righttoroam/stantonbury/09_Reference/Display data/70-800x480-tft-lcd-display-mit-touchscreen-ssd1963-mcu-arduino-kompatibel_3.webp

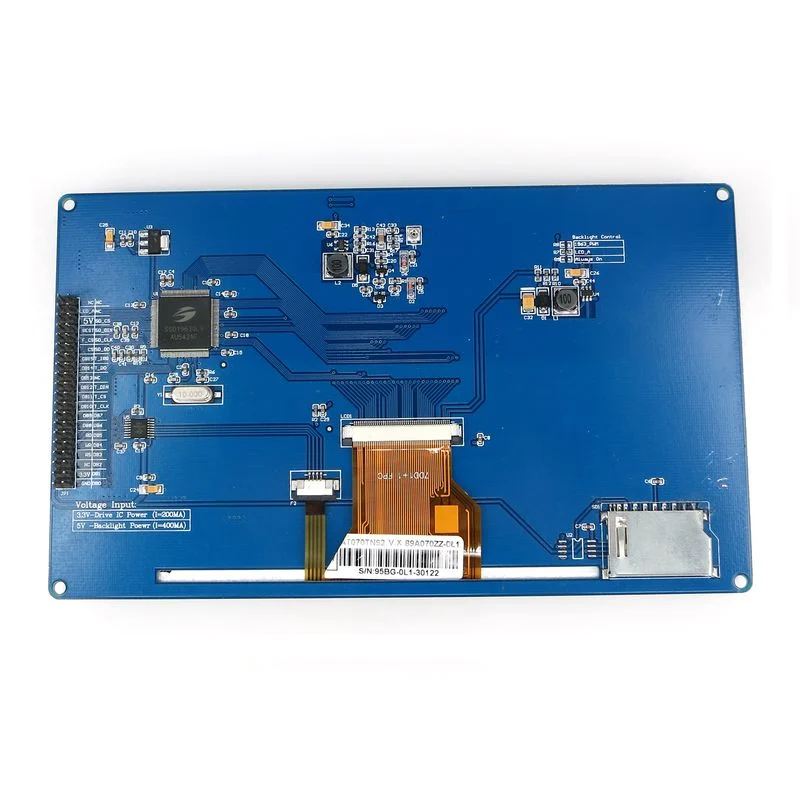
09_Reference/Display data/70-800x480-tft-lcd-display-mit-touchscreen-ssd1963-mcu-arduino-kompatibel_3.webp
