righttoroam/stantonbury/09_Reference/RF-Kit/IMG_2352.jpg

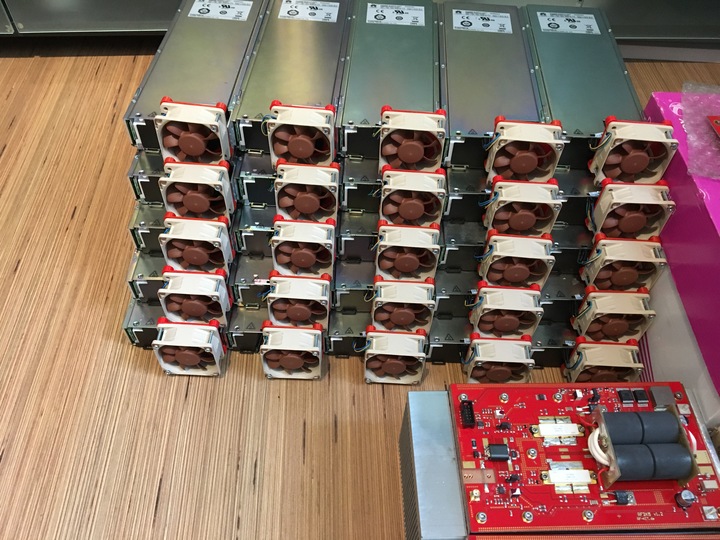
09_Reference/RF-Kit/IMG_2352.jpg
