righttoroam/stantonbury/01_Requirements/PA600 target spec.odt

Target Specification for PA600 Power Amp

Parameter | Target | Compliance
Band coverage | 160 - 6m | Yes
Power output | P1dB >600W on all bands | Yes
IMD3 | <-30dB(PEP) | Yes
Spurious | <-46dBc, 160-10m <-70dBc, 6m | Yes
Input VSWR | <1.5 | Yes
Drive power | options for 5W, 10W or 50W PEP input | Yes
Output VSWR | <1.5 | Yes
Gain variation | <3.0dB across 160 - 10m | TBD
Antenna ports | 2 | Yes
Rating | Continuous transmit: - 600W SSB/CW - 300W RTTY/data Intermittent transmit: - 600W key down for 5 minutes key down followed by 5 minutes rest | Yes
Band selection | Manual Automatic based on transmit frequency Icom C-IV interface Icom Analogue band control | Yes Yes Yes Yes
Operator interface | 4.3 inch or larger touch panel | Yes
Metering | Idd, Vdd, output power, VSWR, temperature | Yes
Safety protection | Over-current, over-temperature, high VSWR, excess drive, wrong band selection | Yes
Remote operation | WiFi | TBD
Acoustic noise | <40dB(A) at 1m | TBD
Mass | <10kg | TBD
Dimensions | Stretch target - Unicase 4 (261 x 300 x 135mm) | TBD
AC input | 220-240V, 50Hz, 5A | Yes
Materials cost | <£1500 | Yes
