righttoroam/stantonbury/02_System_design/Mass estimate.ods

Sheet: Mass budget
Item | Estimated mass kg | Comments
Enclosure | 1.85 | Based on measurement of Metcase Unicase 4
Misc hardware | 0.75 | Screws, connectors, cables, bracketry, fans.
PSU | 1.50 | Datasheet for MSP-1000-48
Pallet
Heatsink | 1.80 | Fischer LA 7 weight 2700g including 100x100x10mm spreader and fans. 0.075K/W, 35 deg rise at 1000W out, 65% efficiency
Spreader | 0.90 | Thinner spreader may be possible depending on thermal design
Fans | 0.18
Fixings | 0.10
Ancilliary components | 0.10 | Some reduction possible from higher integration
LPF |  | W6PQL version weighs 610g. Estimate current design weighs about 1kg. 100g reduction possible from smaller board.
Relays | 0.10
Toroids | 0.35
Misc compts | 0.10
PCB | 0.15
Total estimate | 7.88
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
