righttoroam/stantonbury/02_System_design/Thermal design/Heatsink calc.ods

PA Heatsink Calculator
Parameter | Value | Units | Comments | Key
RF output PEP | 600 | Watts |  | Input
Efficiency | 60% |  |  | Intermediate calc
Peak thermal power | 400 | Watts |  | Result
Mean to peak ratio | 50%
 |  |  |  | Constants
Mean dissipation calculation |  |  |  | s.h.c. of copper | 377 | J/(kg.K)
Mean heat to dissipate | 200 | Watts |  | s.h.c of alu | 921 | J/(kg.K)
Tj max | 175 | C | Max device junction temp | density of cu | 9000 | kg/m^3
Rjc | 0.55 | C/W | Thermal resistance junction to case | density of alu | 2700 | kg/m^3
Rcs | 0.05 | C/W | Thermal resistance case to heatsink
Max sink temp | 55 | C
Inlet temperature | 25 | C
Sink thermal resistance | 0.15 | C/W | NB this is at the max sink temp
Dynamic thermal response
Start temp | 25 | C
Key down period | 300 | secs
Net heat input | 200 | Watts
Thermal energy | 60000 | J
Spreader copper mass (from below) | 0.9 | kg | Density of cu is 9000kg/m^3
Heatsink alu mass | 1.7 | kg | Density of alu is 2700kg/m^3
Heatsink thermal capacity | 1905 | J/K
Temp rise | 31.5 | K
Final temp | 56 | C
Spreader mass estimate
height | 10 | mm
width | 100 | mm
length | 100 | mm
Mass | 0.9 | kg
