righttoroam/stantonbury/03_Detailed_design/Controller/PA600 Micro Pin Assignments V3.ods

 | Pin No | Assignments in code (pin name or alias for pin name) |  | PCB Assignments | Description | Suggested Changes
PA0 | 23 | Uband ADC123_IN0 |  | . | Analogue band input
PA1 | 24 |  |  | NC
PA2 | 25 | USART1 TX |  | WiFiRXD
PA3 | 26 | USART1 RX |  | WiFiTXD
PA4 | 29 | UMESS ADC12_IN4 |  | . | Power supply volts 2.5V = 100V supply
PA5 | 30 | UFWDANT ADC12_IN5 |  | . | Ant Fwd
PA6 | 31 | UREVANT ADC12_IN6 |  | . | Ant Rev
PA7 | 32 | UTEMP ADC12_IN7 |  | . | Temp 1
PA8 | 67 | SW_ONOFF_IN_PA8 |  | NC |  | Delete – Function unknown
PA9 | 68 | USART2 TX |  | CiV TX
PA10 | 69 | USART2 RX |  | CiV RX
PA11 | 70 | SW_RESET_IN_PA11 |  | NC |  | Delete – Function unknown
PA12 | 71 | SW_STANDBY_IN_PA12 |  | NC |  | Delete – Function unknown
PA13 | 72 |  |  | Prog JTMS
PA14 | 76 |  |  | Prog JTCK
PA15 | 77 | ROTS_AUTO_IN_PA15 |  | NC |  | Delete – Was manual LPF input
PB0 | 35 | IMESS ADC12_IN8 |  | . | Supply Current
PB1 | 36 | UFWDIN ADC12_IN9 |  | . | Input Fwd
PB2 | 37 |  |  | Gnd (Boot)
PB3 | 89 |  |  | Prog JTDO
PB4 | 90 | PB4 – LEDRD |  | NJRST (LED Cathode)
PB5 | 91 | PB5 – LEDGN |  | (LED Cathode)
PB6 | 92 | ANT_SEL1_OUT_PB6 |  | . | Antenna select output
PB7 | 93 | BANDREL_1715_OUT_PB7 |  | . | LPF Band Select
PB8 | 95 | ROTS_80M_IN_PB8 |  | TRX Detector pin 3 |  | Delete – Was manual LPF input or multi TX input
PB9 | 96 | BANDREL_1210_OUT_PB9 |  | . | LPF Band Select
PB10 | 47 | USART3 TX |  | UART TX (Bootloader)
PB11 | 48 | USART3 RX |  | UART RX (Bootloader)
PB12 | 51 | BANDREL_6_OUT_PB12 |  | . | LPF Band Select
PB13 | 52 | FATFS_SPI |  | SD_CLK | SD Card
PB14 | 53 | FATFS_SPI |  | SD_DO | SD Card
PB15 | 54 | FATFS_SPI |  | SD_DIN | SD Card
PC0 | 15 | UFWDFLT ADC123_IN10 |  | . | Filter Fwd
PC1 | 16 | UREVFLT ADC123_IN11 | Safety shutdowns | . | Filter Rev
PC2 | 17 | UREVIN ADC123_IN12 |  | . | Input Rev | Delete – No need to measure VSWR on input
PC3 | 18 | UTEMP2 ADC123_IN13 |  | . | Temp 2 | Delete – We only need 1 temperature input
PC4 | 33 | ROTS_6040M_IN_PC4 |  | TRX Detector pin 5 |  | Delete – Was manual LPF input or multi TX input
PC5 | 34 | ROTS_3020M_IN_PC5 |  | TRX Detector pin 7 |  | Delete – Was manual LPF input or multi TX input
PC6 | 63 | ROTS_1715M_IN_PC6 |  | NC |  | Delete – Was manual LPF input
PC7 | 64 | ROTS_1210M_IN_PC7 |  | NC |  | Delete – Was manual LPF input
PC8 | 65 | ROTS_6M_IN_PC8 |  | NC |  | Delete – Was manual LPF input
PC9 | 66 | XPT2046_PORT/XPT2046_CS_PIN |  | T_CS | Touch Screen
PC10 | 78 | XPT2046_PORT/XPT2046_SCK_PIN |  | T_CLK | Touch Screen
PC11 | 79 | XPT2046_PORT/XPT2046_MISO_PIN |  | T_DO | Touch Screen
PC12 | 80 | XPT2046_PORT/XPT2046_MOSI_PIN |  | T_DIN | Touch Screen
PC13 | 7 | ROTS_160M_IN_PC13 |  | TRX Detector pin 1 |  | Was manual LPF input or multi TX input. Repurpose for fan control #2
PC14 | 8 | BANDREL_80_OUT_PC14 |  | . | LPF Band Select
PC15 | 9 | BANDREL_6040_OUT_PC15 |  | . | LPF Band Select
PD0 | 81 | PD0 – hardcoded |  | FMC_D2 | Display data | Note – display interface is very hardcoded and looks pretty messy
PD1 | 82 | PD1 – hardcoded |  | FMC_D3 | Display data
PD2 | 83 | PSOFF_OUT_PD2 |  | .
PD3 | 84 | FATFS_CS_PORT/FATFS_CS_PIN |  | Disp SD_CS | Display
PD4 | 85 | PD4 – hardcoded |  | Disp /RD | Display
PD5 | 86 | PD5 – hardcoded |  | Disp /WR | Display
PD6 | 87 | ICOM_TKEY_IN_PD6 |  | NC |  | Delete – Not used in vserion 7.2 board
PD7 | 88 | PD7 – hardcoded |  | Disp /CS | Display
PD8 | 55 | PD8 – hardcoded |  | FMC_D13 | Display data
PD9 | 56 | PD9 – hardcoded |  | FMC_D14 | Display data
PD10 | 57 | PD10 – hardcoded |  | FMC_D15 | Display data
PD11 | 58 | PD11 – hardcoded |  | Disp RS | Display
PD12 | 59 | PD12 - hardcoded |  | Disp /RES | Display
PD13 | 60 | ANT_SEL2_OUT_PD13 |  |  | Antenna select output | Delete – We only need 2 antenna sockets
PD14 | 61 | PD14 – hardcoded |  | FMC_D0 | Display data
PD15 | 62 | PD15 – hardcoded |  | FMC_D1 | Display data
PE0 | 97 | BANDREL_3020_OUT_PE0 |  | . | LPF Band Select
PE1 | 98 | LCD_BACKLIGHT_OUT_PE1 |  | . | LCD Bavklight control
PE2 | 1 | PTTIN_IN_PE2 |  | . | PTT Input
PE3 | 2 | PSON_OUT_PE3 |  | . | Power On
PE4 | 3 | FAN_OUT_PE4 |  | . | Fan Control | Re-purpose for Fan control #1
PE5 | 4 | BIAS_OUT_PE5 |  | NC |  | Bias On
PE6 | 5 | PTTOUT_OUT_PE6 |  | . |  | Change to TX relay
PE7 | 38 | PE7 - hardcoded |  | FMC_D4 | Display data
PE8 | 39 | PE8 – hardcoded |  | FMC_D5 | Display data
PE9 | 40 | PE9 – hardcoded |  | FMC_D6 | Display data
PE10 | 41 | PE10 – hardcoded |  | FMC_D7 | Display data
PE11 | 42 | PE11 – hardcoded |  | FMC_D8 | Display data
PE12 | 43 | PE12 – hardcoded |  | FMC_D9 | Display data
PE13 | 44 | PE13 – hardcoded |  | FMC_D10 | Display data
PE14 | 45 | PE14 – hardcoded |  | FMC_D11 | Display data
PE15 | 46 | PE15 – hardcoded |  | FMC_D12 | Display data
VBAT | 6
VDD1 | 50
VDD2 | 75
VDD3 | 100
VDD4 | 28
VDD5 | 11
VDD12 | 19
VDDA | 22
VSSA | 20
VSS2 | 74
VSS4 | 27
VSS5 | 10
VREF | 21
VCAP1 | 49
VCAP2 | 73
BOOT0 | 94
OSCin | 12
OSCout | 13
RFV | 99
RST | 14
