righttoroam/stantonbury/09_Reference/M0HZH/circuit-schematic.png

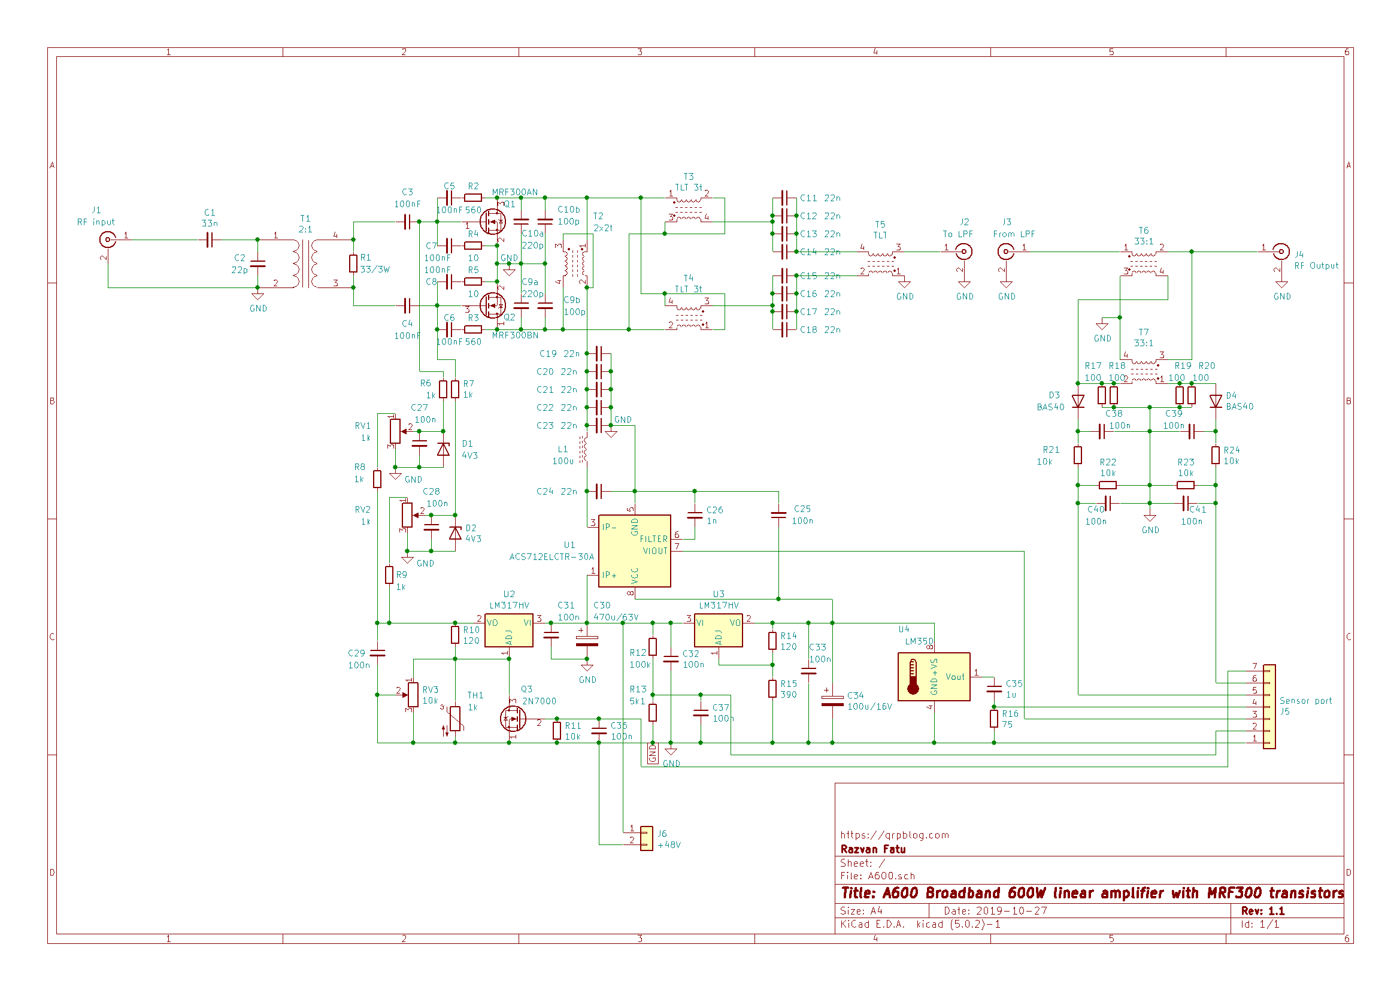
09_Reference/M0HZH/circuit-schematic.png
