righttoroam/stantonbury/09_Reference/RF-Kit/Cooper%20plate%20between%20heat%20sink%20and%20PA%20board.jpg

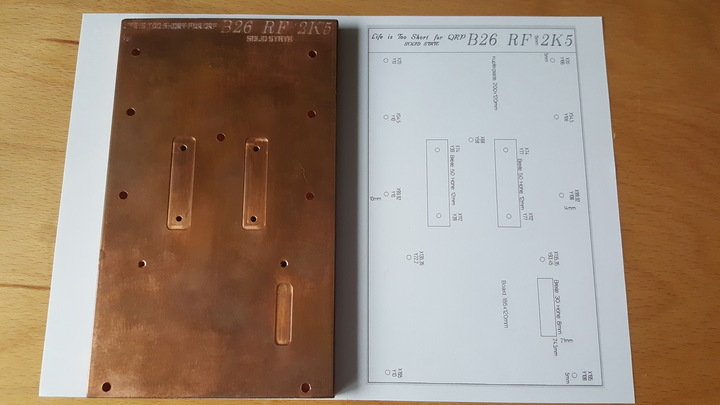
09_Reference/RF-Kit/Cooper%20plate%20between%20heat%20sink%20and%20PA%20board.jpg
