righttoroam/stantonbury/09_Reference/RF-Kit/dcaecfic.jpg

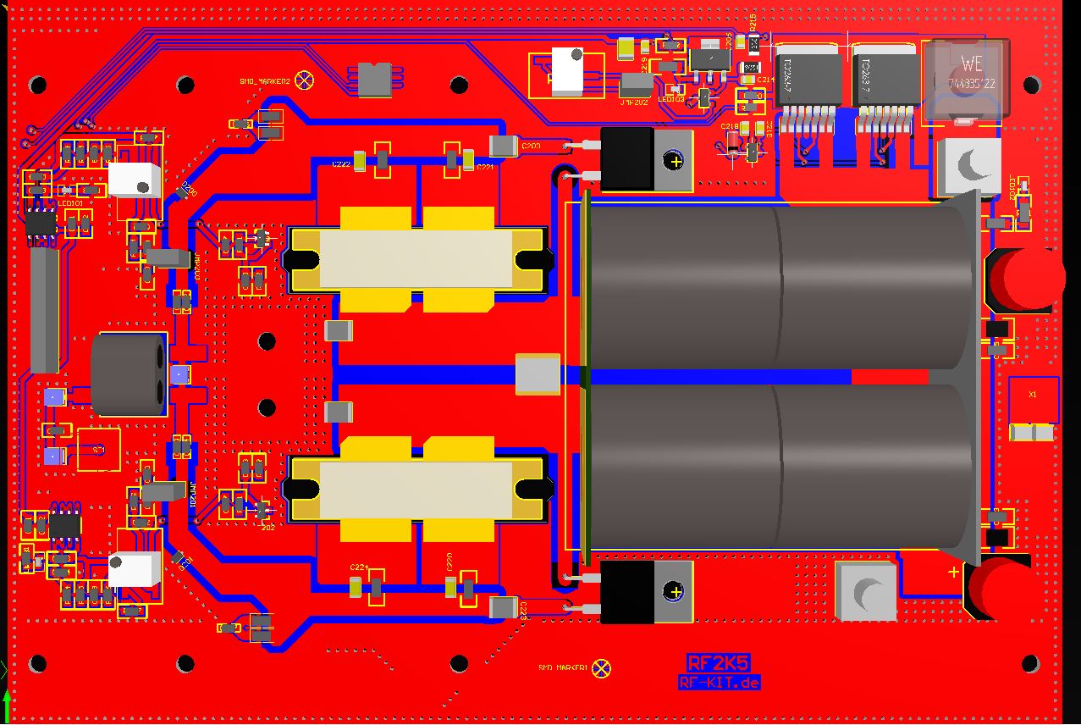
09_Reference/RF-Kit/dcaecfic.jpg
