righttoroam/stantonbury/09_Reference/RF-Kit/PA%20mit%20LPF.jpg

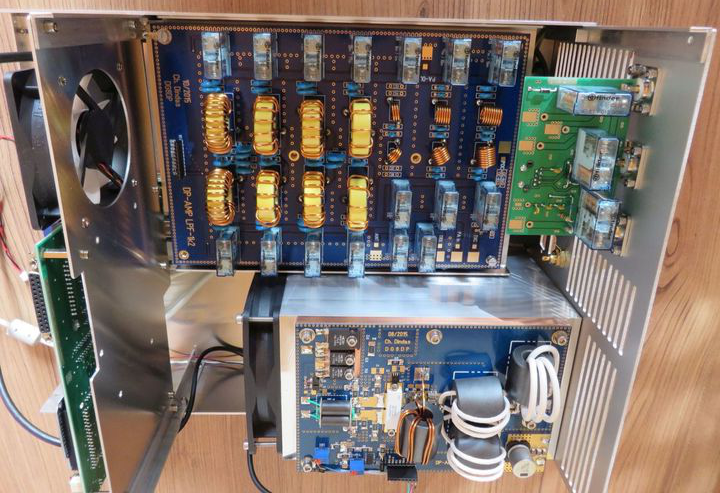
09_Reference/RF-Kit/PA%20mit%20LPF.jpg
