righttoroam/stantonbury/09_Reference/RF-Kit/Pallet v1.1 G4KCM.jpg

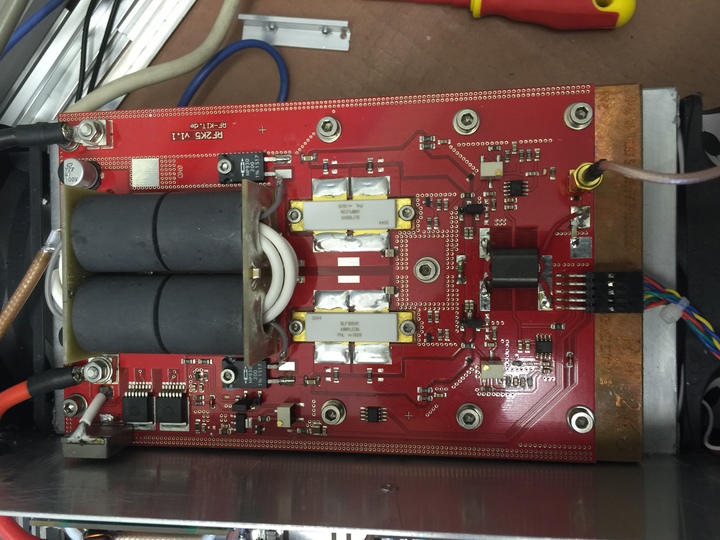
09_Reference/RF-Kit/Pallet v1.1 G4KCM.jpg
