righttoroam/stantonbury/09_Reference/RF-Kit/RF2k+.jpg

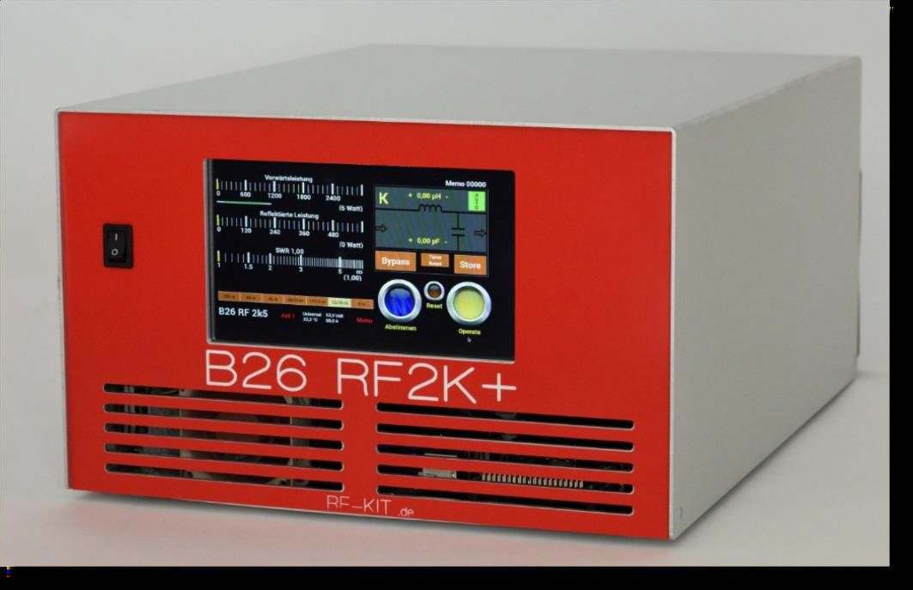
09_Reference/RF-Kit/RF2k+.jpg
