righttoroam/stantonbury/05_Schematics_PCB/Eagle/display72.brd

## EAGLE design 05_Schematics_PCB/Eagle/display72.brd (2020-11-11)

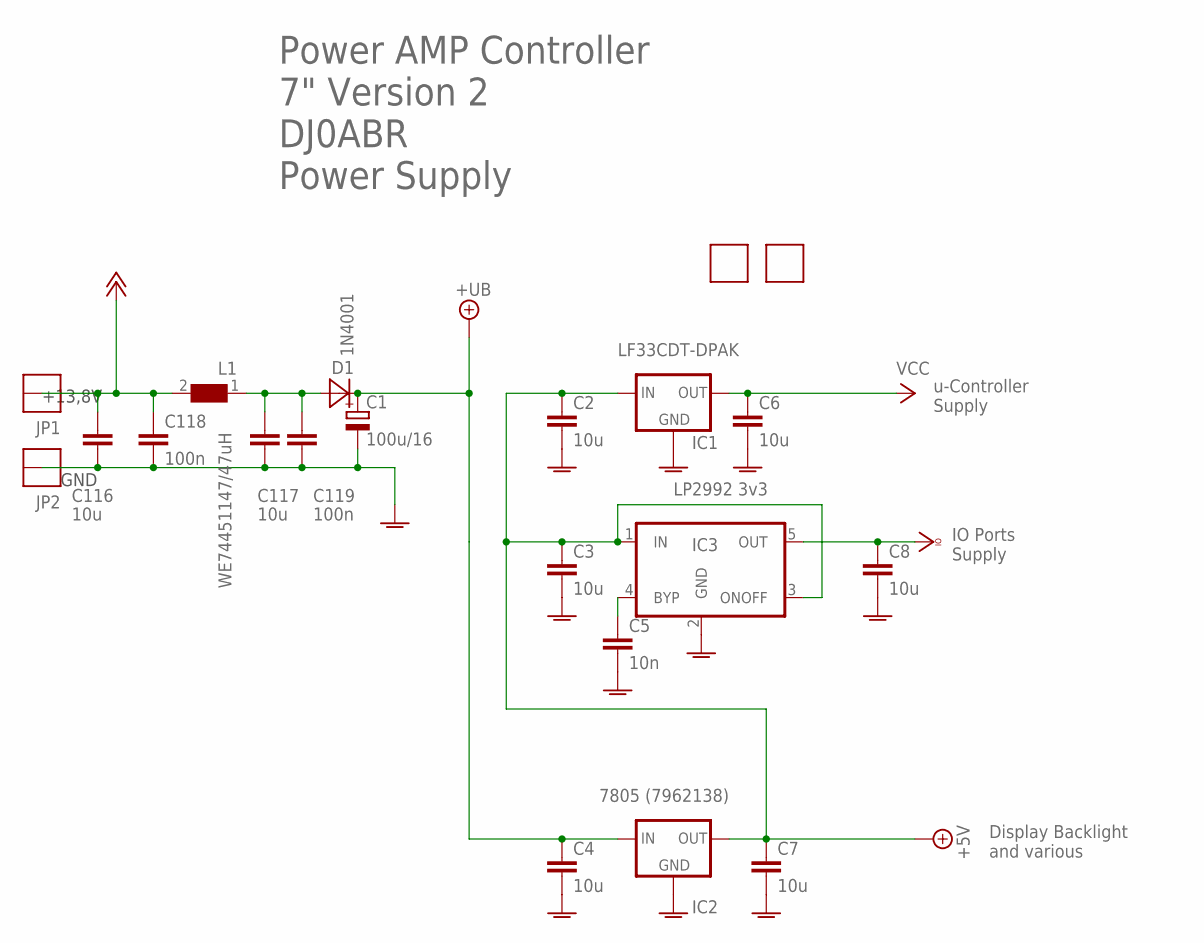
[picture p39: schematic display72.sch, sheet 1, Powersupply]

Parts:
C1: 100u/16; E2,5-7
C2, C3, C4, C116, C117: 10u; C0805
C5: 10n; C0603
C6, C7, C8: 10u; C0603
C118, C119: 100n; C0603
D1: 1N4001; MELF
FID1, FID2: FIDUCIAL
IC1: LF33CDT-DPAK; DPACK
IC2: 7805 (7962138); 78SR_SWITCHREG
IC3: LP2992 3v3; SOT23-5
JP1, JP2: THICKPINSQUARE; THICKPIN
L1: WE74451147/47uH; S

Connections:
+5V: C2.1, C3.1, C7.1, IC1.1 (IN), IC2.3 (OUT), IC3.1 (IN), IC3.3 (ONOFF); also elsewhere on the board
+UB: C1.+, C4.1, D1.1 (C), IC2.1 (IN)
AGND: C1.-, C2.2, C3.2, C4.2, C5.2, C6.2, C7.2, C8.2, C116.2, C117.2, C118.2, C119.2, IC1.4 (GND), IC2.2 (GND), IC3.2 (GND), JP2.1; also elsewhere on the board
unnamed: C117.1, C119.1, D1.2 (A), L1.1
unnamed: C5.1, IC3.4 (BYP)
PLUSZWOELF: C116.1, C118.1, JP1.1, L1.2; also elsewhere on the board
VCC: C6.1, IC1.3 (OUT); also elsewhere on the board
VCCIO: C8.1, IC3.5 (OUT); also elsewhere on the board

Notes on the sheet:
GND
+13,8V
Power AMP Controller 7" Version 2 DJ0ABR Power Supply
u-Controller Supply
IO Ports Supply
Display Backlight and various

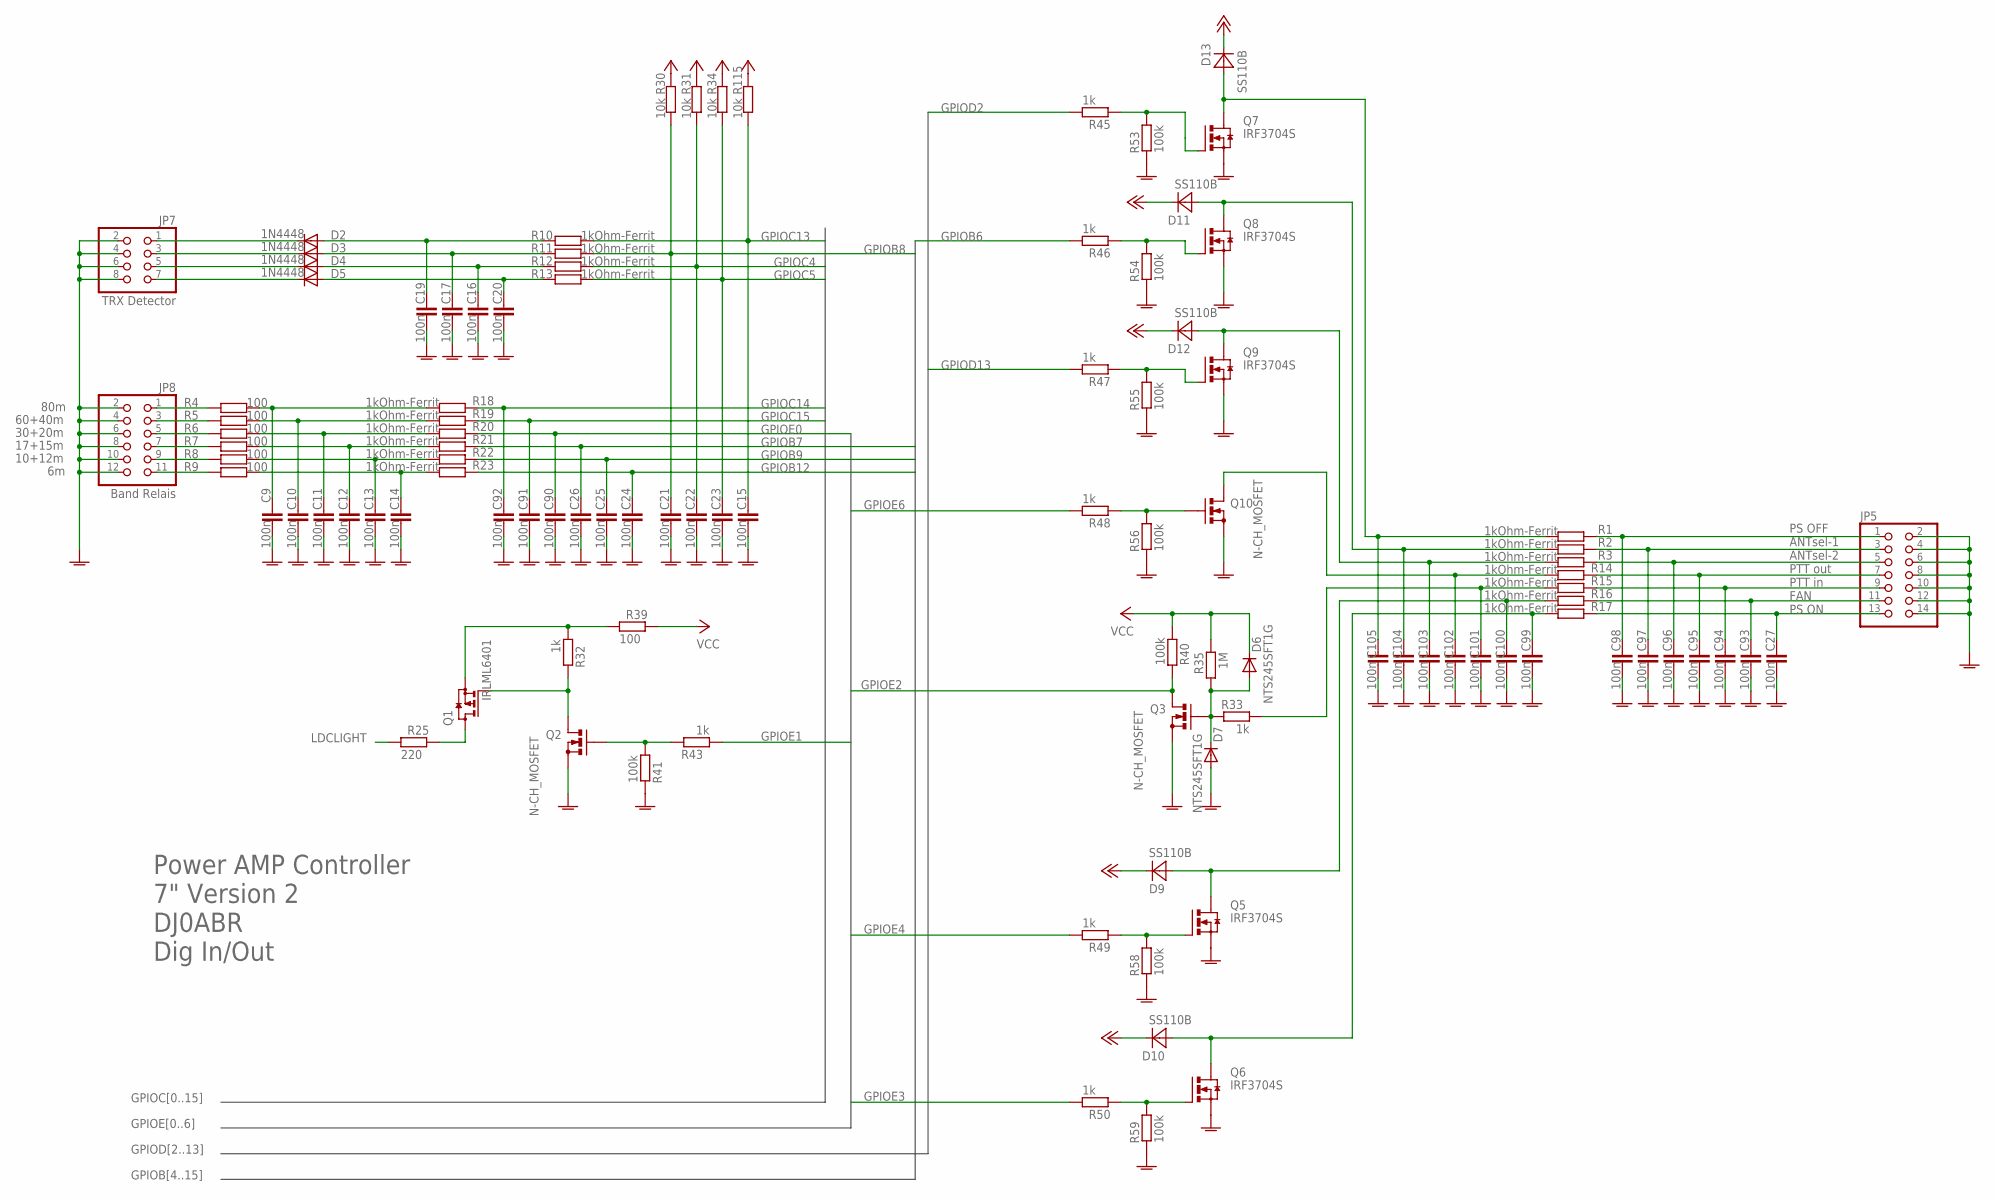
[picture p40: schematic display72.sch, sheet 2, IO Ports LED,PTT,Switch]

Parts:
C9, C10, C11, C12, C13, C14, C15, C16, C17, C19, C20, C21, C22, C23, C24, C25, C26, C27, C90, C91, C92, C93, C94, C95, C96, C97, C98, C99, C100, C101, C102, C103, C104, C105: 100n; C0603
D2, D3, D4, D5: 1N4448; SOD523
D6, D7: NTS245SFT1G; MINIMELF
D9, D10, D11, D12, D13: SS110B; MELF
JP5: PINHD-2X7/90; 2X07/90
JP7: TRX Detector; 2X04/90
JP8: Band Relais; 2X06/90
Q1: IRLML6401; SOT23
Q2, Q3, Q10: N-CH_MOSFET; SOT23
Q5, Q6, Q7, Q8, Q9: IRF3704S; D2PACK
R1, R2, R3, R10, R11, R12, R13, R14, R15, R16, R17, R18, R19, R20, R21, R22, R23: 1kOhm-Ferrit; R0603
R4, R5, R6, R7, R8, R9, R39: 100; R0603
R25: 220; R0603
R30, R31, R34, R115: 10k; R0603
R32, R33, R43, R45, R46, R47, R48, R49, R50: 1k; R0603
R35: 1M; R0603
R40, R41, R53, R54, R55, R56, R58, R59: 100k; R0603

Connections:
AGND: C9.2, C10.2, C11.2, C12.2, C13.2, C14.2, C15.2, C16.2, C17.2, C19.2, C20.2, C21.2, C22.2, C23.2, C24.2, C25.2, C26.2, C27.2, C90.2, C91.2, C92.2, C93.2, C94.2, C95.2, C96.2, C97.2, C98.2, C99.2, C100.2, C101.2, C102.2, C103.2, C104.2, C105.2, D7.A, JP5.2, JP5.4, JP5.6, JP5.8, JP5.10, JP5.12, JP5.14, JP7.2, JP7.4, JP7.6, JP7.8, JP8.2, JP8.4, JP8.6, JP8.8, JP8.10, JP8.12, Q2.2 (S), Q3.2 (S), Q5.3 (S), Q6.3 (S), Q7.3 (S), Q8.3 (S), Q9.3 (S), Q10.2 (S), R41.2, R53.2, R54.2, R55.2, R56.2, R58.2, R59.2; also elsewhere on the board
GPIOB6: R46.1; also elsewhere on the board
GPIOB7: C26.1, R21.1; also elsewhere on the board
GPIOB8: C21.1, R11.2, R30.1; also elsewhere on the board
GPIOB9: C25.1, R22.1; also elsewhere on the board
GPIOB12: C24.1, R23.1; also elsewhere on the board
GPIOC4: C22.1, R12.2, R31.1; also elsewhere on the board
GPIOC5: C23.1, R13.2, R34.1; also elsewhere on the board
GPIOC13: C15.1, R10.2, R115.1; also elsewhere on the board
GPIOC14: C92.1, R18.1; also elsewhere on the board
GPIOC15: C91.1, R19.1; also elsewhere on the board
GPIOD2: R45.1; also elsewhere on the board
GPIOD13: R47.1; also elsewhere on the board
GPIOE0: C90.1, R20.1; also elsewhere on the board
GPIOE1: R43.1; also elsewhere on the board
GPIOE2: Q3.3 (D), R40.1; also elsewhere on the board
GPIOE3: R50.1; also elsewhere on the board
GPIOE4: R49.1; also elsewhere on the board
GPIOE6: R48.1; also elsewhere on the board
LDCLIGHT: R25.1; also elsewhere on the board
unnamed: Q10.1 (G), R48.2, R56.1
unnamed: C102.1, Q10.3 (D), R14.2
unnamed: D6.A, D7.C, Q3.1 (G), R33.2, R35.2
unnamed: Q2.1 (G), R41.1, R43.2
unnamed: Q1.1 (G), Q2.3 (D), R32.2
unnamed: Q1.3 (D), R25.2
unnamed: JP8.1, R4.1
unnamed: C98.1, JP5.1, R1.1
unnamed: Q9.1 (G), R47.2, R55.1
unnamed: C103.1, D12.2 (A), Q9.2 (D), R3.2
unnamed: C97.1, JP5.3, R2.1
unnamed: C96.1, JP5.5, R3.1
unnamed: C95.1, JP5.7, R14.1
unnamed: C94.1, JP5.9, R15.1
unnamed: C93.1, JP5.11, R16.1
unnamed: D3.C, JP7.3
unnamed: D4.C, JP7.5
unnamed: D5.C, JP7.7
unnamed: C27.1, JP5.13, R17.1
unnamed: C9.1, R4.2, R18.2
unnamed: C14.1, R9.2, R23.2
unnamed: C13.1, R8.2, R22.2
unnamed: C12.1, R7.2, R21.2
unnamed: C11.1, R6.2, R20.2
unnamed: C10.1, R5.2, R19.2
unnamed: Q1.2 (S), R32.1, R39.1
unnamed: D2.C, JP7.1
unnamed: Q8.1 (G), R46.2, R54.1
unnamed: C104.1, D11.2 (A), Q8.2 (D), R2.2
unnamed: JP8.3, R5.1
unnamed: JP8.5, R6.1
unnamed: Q7.1 (G), R45.2, R53.1
unnamed: JP8.7, R7.1
unnamed: JP8.9, R8.1
unnamed: JP8.11, R9.1
unnamed: C105.1, D13.2 (A), Q7.2 (D), R1.2
unnamed: C19.1, D2.A, R10.1
unnamed: C17.1, D3.A, R11.1
unnamed: C16.1, D4.A, R12.1
unnamed: C20.1, D5.A, R13.1
unnamed: C100.1, D9.2 (A), Q5.2 (D), R16.2
unnamed: Q5.1 (G), R49.2, R58.1
unnamed: C99.1, D10.2 (A), Q6.2 (D), R17.2
unnamed: Q6.1 (G), R50.2, R59.1
PLUSZWOELF: D9.1 (C), D10.1 (C), D11.1 (C), D12.1 (C), D13.1 (C); also elsewhere on the board
PTT: C101.1, R15.2, R33.1
VCC: D6.C, R30.2, R31.2, R34.2, R35.1, R39.2, R40.2, R115.2; also elsewhere on the board

Notes on the sheet:
80m
60+40m
30+20m
17+15m
10+12m
Power AMP Controller 7" Version 2 DJ0ABR Dig In/Out
PS OFF ANTsel-1 ANTsel-2 PTT out PTT in FAN PS ON

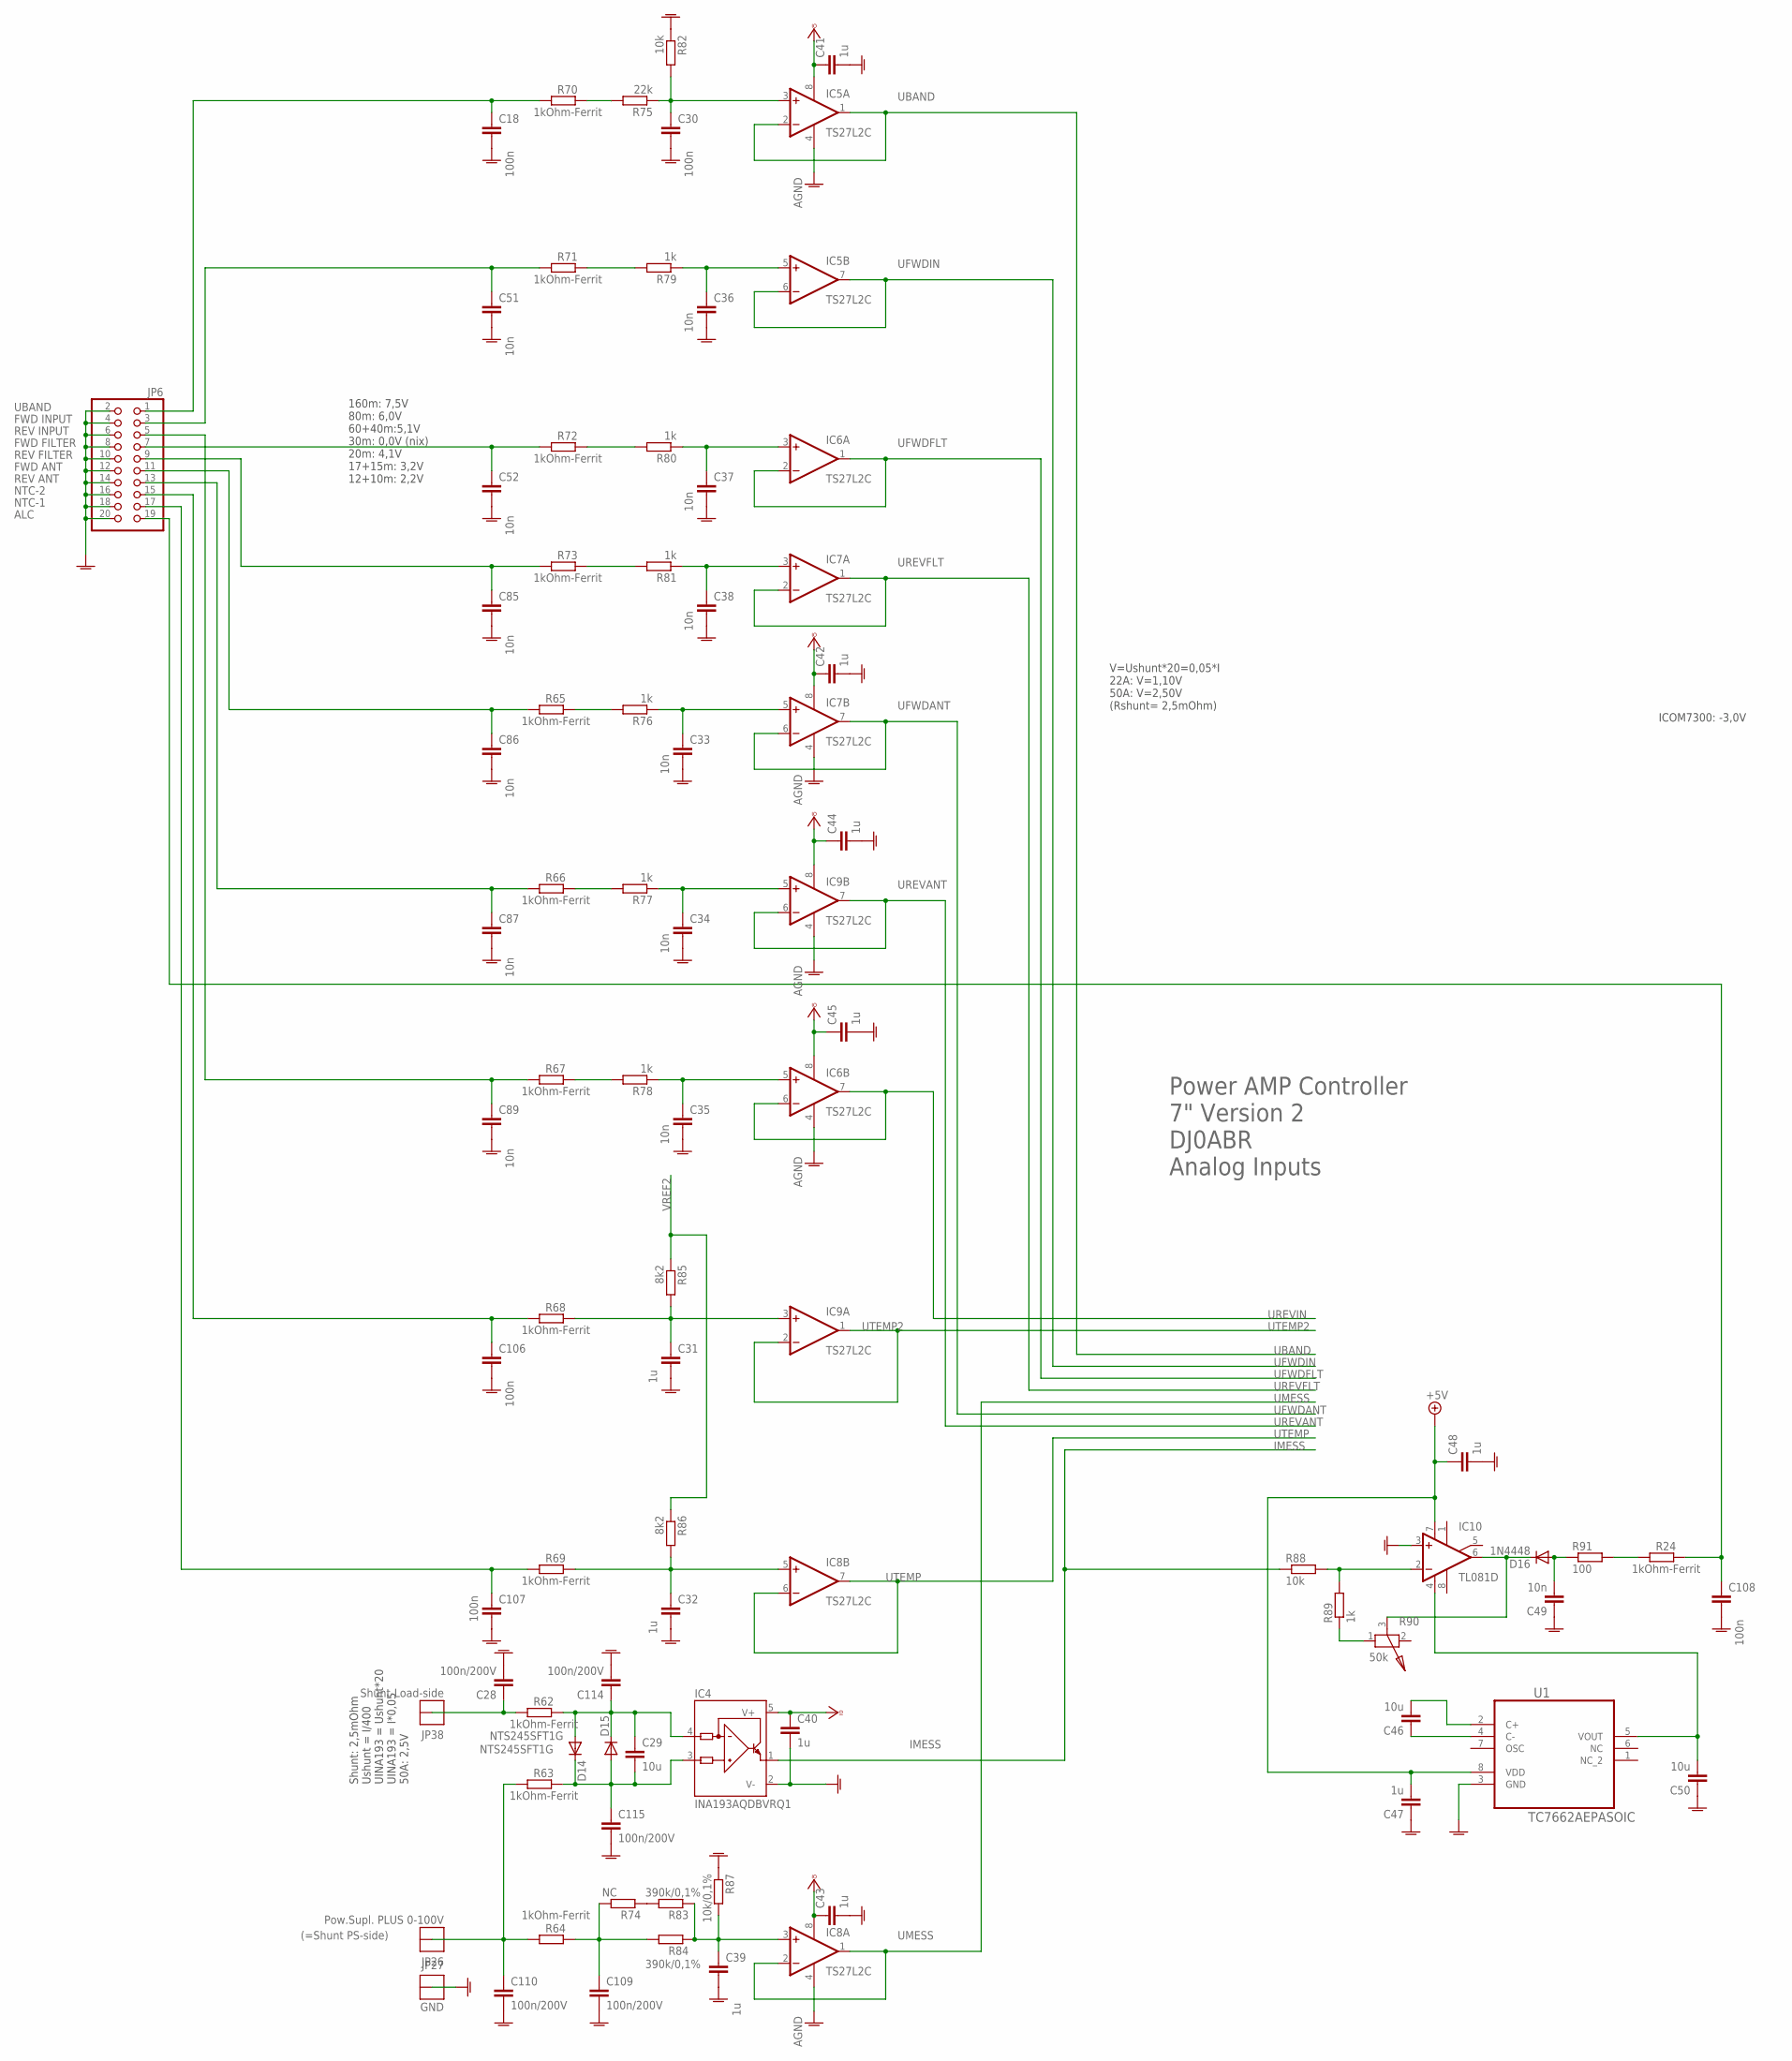
[picture p41: schematic display72.sch, sheet 3, ANALOG]

Parts:
C18, C30, C106, C107, C108: 100n; C0603
C28, C109, C110, C114, C115: 100n/200V; C1206K
C29: 10u; C0805
C31, C32, C39, C40, C41, C42, C43, C44, C45, C47, C48: 1u; C0603
C33, C34, C35, C36, C37, C38, C49, C51, C52, C85, C86, C87, C89: 10n; C0603
C46, C50: 10u; C0603
D14, D15: NTS245SFT1G; MINIMELF
D16: 1N4448; SOD523
IC4: INA193AQDBVRQ1; SOT23-5
IC5, IC6, IC7, IC8, IC9: TS27L2C; SO08
IC10: TL081D; SO08
JP6: PINHD-2X10/90; 2X10/90
JP26: Pow.Supl. PLUS 0-100V; THICKPIN
JP27: GND; THICKPIN
JP38: Shunt-Load-side; THICKPIN
R24, R62, R63, R64, R65, R66, R67, R68, R69, R70, R71, R72, R73: 1kOhm-Ferrit; R0603
R74: NC; R0603
R75: 22k; R0603
R76, R77, R78, R79, R80, R81, R89: 1k; R0603
R82, R88: 10k; R0603
R83, R84: 390k/0,1%; R0603
R85, R86: 8k2; R0603
R87: 10k/0,1%; R0603
R90: 50k; MINIPOTI
R91: 100; R0603
U1: TC7662AEPASOIC; SO-8

Connections:
+5V: C47.2, C48.1, IC10.7 (V+), U1.8 (VDD); also elsewhere on the board
AGND: C18.2, C28.2, C30.2, C31.2, C32.2, C33.2, C34.2, C35.2, C36.2, C37.2, C38.2, C39.2, C40.2, C41.2, C42.2, C43.2, C44.2, C45.2, C47.1, C48.2, C49.1, C50.1, C51.2, C52.2, C85.2, C86.2, C87.2, C89.2, C106.2, C107.2, C108.2, C109.2, C110.2, C114.2, C115.2, IC4.2 (V-), IC5.4 (V-), IC6.4 (V-), IC7.4 (V-), IC8.4 (V-), IC9.4 (V-), IC10.3 (+IN), JP6.2, JP6.4, JP6.6, JP6.8, JP6.10, JP6.12, JP6.14, JP6.16, JP6.18, JP6.20, JP27.1, R82.1, R87.1, U1.3 (GND); also elsewhere on the board
IMESS: IC4.1 (OUT), R88.1; also elsewhere on the board
unnamed: R24.1, R91.2
unnamed: R70.2, R75.2
unnamed: R71.2, R79.2
unnamed: R72.2, R80.2
unnamed: C30.1, IC5.3 (+IN), R75.1, R82.2
unnamed: C18.1, JP6.1, R70.1
unnamed: R73.2, R81.2
unnamed: C109.1, R64.2, R74.2, R84.2
unnamed: R65.2, R76.2
unnamed: R66.2, R77.2
unnamed: C39.1, IC8.3 (+IN), R83.1, R84.1, R87.2
unnamed: C33.1, IC7.5 (+IN), R76.1
unnamed: C86.1, JP6.11, R65.1
unnamed: C34.1, IC9.5 (+IN), R77.1
unnamed: C87.1, JP6.13, R66.1
unnamed: C29.1, C114.1, D14.A, D15.C, IC4.4 (IN-), R62.2
unnamed: C29.2, C115.1, D14.C, D15.A, IC4.3 (IN+), R63.2
unnamed: C28.1, JP38.1, R62.1
unnamed: C110.1, JP26.1, R63.1, R64.1
unnamed: C32.1, IC8.5 (+IN), R69.2, R86.2
unnamed: C107.1, JP6.17, R69.1
unnamed: C38.1, IC7.3 (+IN), R81.1
unnamed: C85.1, JP6.9, R73.1
unnamed: C37.1, IC6.3 (+IN), R80.1
unnamed: C52.1, JP6.7, R72.1
unnamed: C36.1, IC5.5 (+IN), R79.1
unnamed: C51.1, JP6.3, R71.1
unnamed: C35.1, IC6.5 (+IN), R78.1
unnamed: C89.1, JP6.5, R67.1
unnamed: R67.2, R78.2
unnamed: C31.1, IC9.3 (+IN), R68.2, R85.2
unnamed: C106.1, JP6.15, R68.1
unnamed: R74.1, R83.2
unnamed: C46.1, U1.4 (C-)
unnamed: C46.2, U1.2 (C+)
unnamed: C50.2, IC10.4 (V-), U1.5 (VOUT)
unnamed: D16.C, IC10.6 (OUT), R90.3
unnamed: C108.1, JP6.19, R24.2
unnamed: IC10.2 (-IN), R88.2, R89.2
unnamed: R89.1, R90.1
unnamed: C49.2, D16.A, R91.1
UBAND: IC5.1 (OUT), IC5.2 (-IN); also elsewhere on the board
UFWDANT: IC7.6 (-IN), IC7.7 (OUT); also elsewhere on the board
UFWDFLT: IC6.1 (OUT), IC6.2 (-IN); also elsewhere on the board
UFWDIN: IC5.6 (-IN), IC5.7 (OUT); also elsewhere on the board
UMESS: IC8.1 (OUT), IC8.2 (-IN); also elsewhere on the board
UREVANT: IC9.6 (-IN), IC9.7 (OUT); also elsewhere on the board
UREVFLT: IC7.1 (OUT), IC7.2 (-IN); also elsewhere on the board
UREVIN: IC6.6 (-IN), IC6.7 (OUT); also elsewhere on the board
UTEMP: IC8.6 (-IN), IC8.7 (OUT); also elsewhere on the board
UTEMP2: IC9.1 (OUT), IC9.2 (-IN); also elsewhere on the board
VCCIO: C40.1, C41.1, C42.1, C43.1, C44.1, C45.1, IC4.5 (V+), IC5.8 (V+), IC6.8 (V+), IC7.8 (V+), IC8.8 (V+), IC9.8 (V+); also elsewhere on the board
VREF2: R85.1, R86.1; also elsewhere on the board

Notes on the sheet:
V=Ushunt*20=0,05*I 22A: V=1,10V 50A: V=2,50V (Rshunt= 2,5mOhm)
ICOM7300: -3,0V
160m: 7,5V 80m: 6,0V 60+40m:5,1V 30m: 0,0V (nix) 20m: 4,1V 17+15m: 3,2V 12+10m: 2,2V
Shunt: 2,5mOhm Ushunt = I/400 UINA193 = Ushunt*20 UINA193 = I*0,05 50A: 2,5V
Power AMP Controller 7" Version 2 DJ0ABR Analog Inputs
UBAND
FWD INPUT
REV INPUT
FWD FILTER
REV FILTER
FWD ANT
REV ANT
NTC-2
NTC-1
ALC
(=Shunt PS-side)

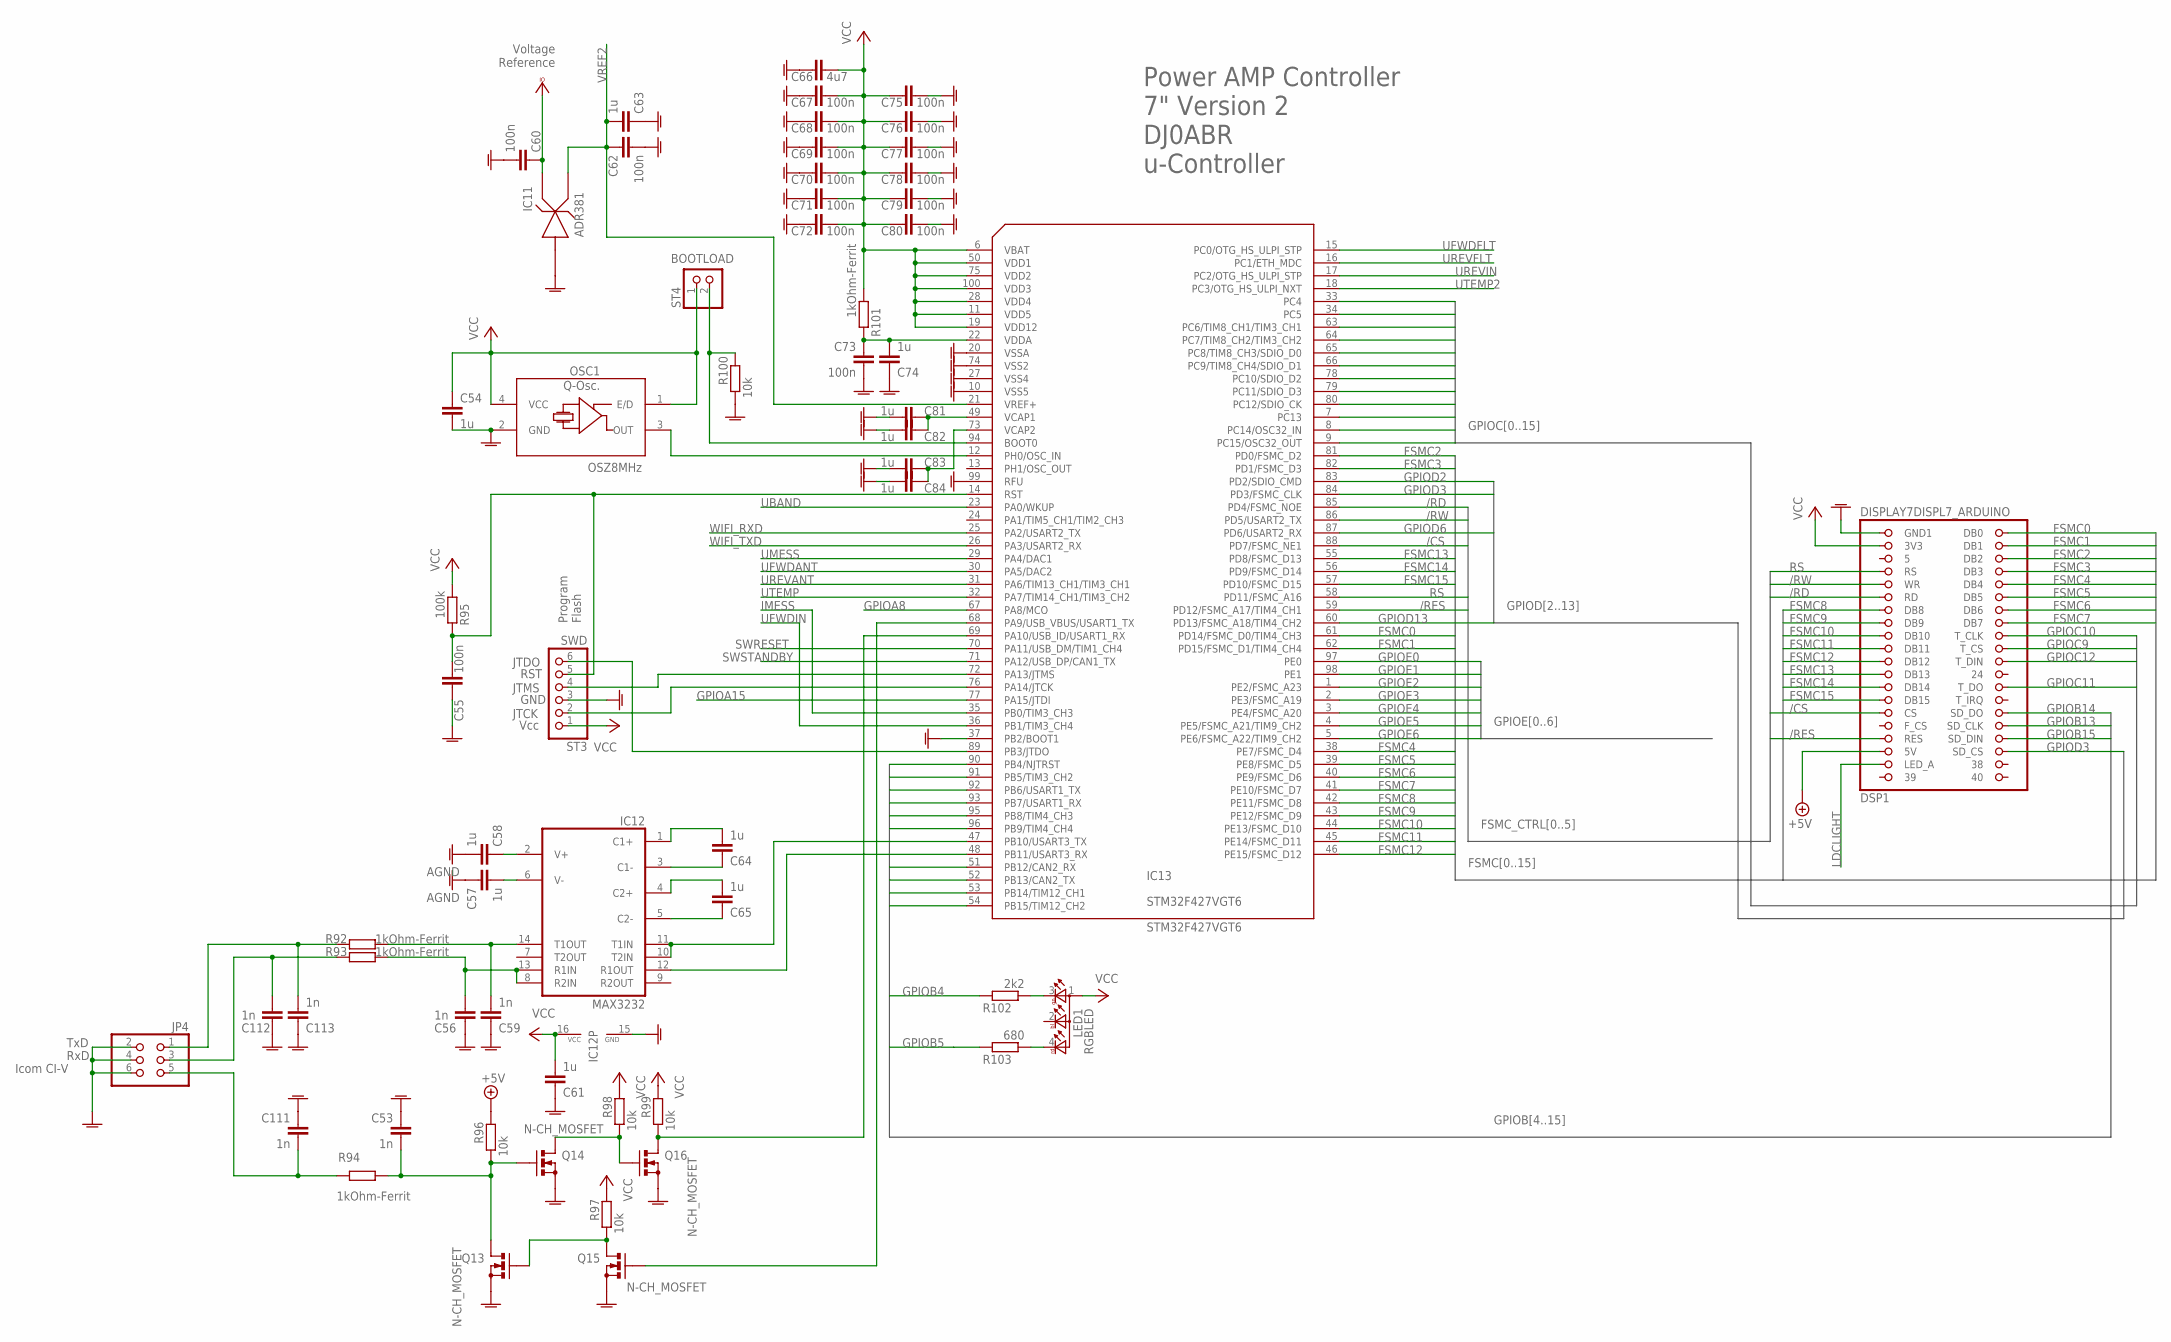
[picture p42: schematic display72.sch, sheet 4, CPU]

Parts:
C53, C56, C59, C111, C112, C113: 1n; C0603
C54, C57, C58, C64, C65, C81, C82, C83, C84: 1u; C0603K
C55, C60, C62, C67, C68, C69, C70, C71, C72, C73, C75, C76, C77, C78, C79, C80: 100n; C0603
C61, C63, C74: 1u; C0603
C66: 4u7; C0603
DSP1: DISPLAY7DISPL7_ARDUINO; 2X20
IC11: ADR381; SOT23
IC12: MAX3232; SO16
IC13: STM32F427VGT6; TQFP100
JP4: PINHD-2X3/90; 2X03/90
LED1: RGBLED; PLCC4_WE_LED
OSC1: OSZ8MHz; QOSC_AQO7015
Q13, Q14, Q15, Q16: N-CH_MOSFET; SOT23
R92, R93, R94, R101: 1kOhm-Ferrit; R0603
R95: 100k; R0603
R96, R97, R98, R99, R100: 10k; R0603
R102: 2k2; R0603
R103: 680; R0603
ST3: SWD; PINHEAD6X1
ST4: PINHEAD2X1SMALL; PINHEAD1X2

Connections:
+5V: DSP1.35 (5V), R96.2; also elsewhere on the board
/CS: DSP1.29 (CS), IC13.88 (PD7/FSMC_NE1)
/RD: DSP1.11 (RD), IC13.85 (PD4/FSMC_NOE)
/RES: DSP1.33 (RES), IC13.59 (PD12/FSMC_A17/TIM4_CH1)
/RW: DSP1.9 (WR), IC13.86 (PD5/USART2_TX)
AGND: C53.1, C54.2, C55.1, C56.1, C57.1, C58.2, C59.1, C60.2, C61.1, C62.2, C63.1, C66.1, C67.1, C68.1, C69.1, C70.1, C71.1, C72.1, C73.2, C74.1, C75.2, C76.2, C77.2, C78.2, C79.2, C80.2, C81.1, C82.1, C83.1, C84.1, C111.1, C112.1, C113.1, DSP1.1 (GND1), IC11.3 (A), IC12.15 (GND), IC13.10 (VSS5), IC13.20 (VSSA), IC13.27 (VSS4), IC13.37 (PB2/BOOT1), IC13.74 (VSS2), IC13.99 (RFU), JP4.2, JP4.4, JP4.6, OSC1.2 (GND), Q13.2 (S), Q14.2 (S), Q15.2 (S), Q16.2 (S), R100.1, ST3.3; also elsewhere on the board
FSMC0: DSP1.2 (DB0), IC13.61 (PD14/FSMC_D0/TIM4_CH3)
FSMC1: DSP1.4 (DB1), IC13.62 (PD15/FSMC_D1/TIM4_CH4)
FSMC2: DSP1.6 (DB2), IC13.81 (PD0/FSMC_D2)
FSMC3: DSP1.8 (DB3), IC13.82 (PD1/FSMC_D3)
FSMC4: DSP1.10 (DB4), IC13.38 (PE7/FSMC_D4)
FSMC5: DSP1.12 (DB5), IC13.39 (PE8/FSMC_D5)
FSMC6: DSP1.14 (DB6), IC13.40 (PE9/FSMC_D6)
FSMC7: DSP1.16 (DB7), IC13.41 (PE10/FSMC_D7)
FSMC8: DSP1.13 (DB8), IC13.42 (PE11/FSMC_D8)
FSMC9: DSP1.15 (DB9), IC13.43 (PE12/FSMC_D9)
FSMC10: DSP1.17 (DB10), IC13.44 (PE13/FSMC_D10)
FSMC11: DSP1.19 (DB11), IC13.45 (PE14/FSMC_D11)
FSMC12: DSP1.21 (DB12), IC13.46 (PE15/FSMC_D12)
FSMC13: DSP1.23 (DB13), IC13.55 (PD8/FSMC_D13)
FSMC14: DSP1.25 (DB14), IC13.56 (PD9/FSMC_D14)
FSMC15: DSP1.27 (DB15), IC13.57 (PD10/FSMC_D15)
GPIOA8: IC13.67 (PA8/MCO)
GPIOA15: IC13.77 (PA15/JTDI)
GPIOB4: IC13.90 (PB4/NJTRST), R102.2
GPIOB5: IC13.91 (PB5/TIM3_CH2), R103.2
GPIOB6: IC13.92 (PB6/USART1_TX); also elsewhere on the board
GPIOB7: IC13.93 (PB7/USART1_RX); also elsewhere on the board
GPIOB8: IC13.95 (PB8/TIM4_CH3); also elsewhere on the board
GPIOB9: IC13.96 (PB9/TIM4_CH4); also elsewhere on the board
GPIOB12: IC13.51 (PB12/CAN2_RX); also elsewhere on the board
GPIOB13: DSP1.32 (SD_CLK), IC13.52 (PB13/CAN2_TX)
GPIOB14: DSP1.30 (SD_DO), IC13.53 (PB14/TIM12_CH1)
GPIOB15: DSP1.34 (SD_DIN), IC13.54 (PB15/TIM12_CH2)
GPIOC4: IC13.33 (PC4); also elsewhere on the board
GPIOC5: IC13.34 (PC5); also elsewhere on the board
GPIOC6: IC13.63 (PC6/TIM8_CH1/TIM3_CH1)
GPIOC7: IC13.64 (PC7/TIM8_CH2/TIM3_CH2)
GPIOC8: IC13.65 (PC8/TIM8_CH3/SDIO_D0)
GPIOC9: DSP1.20 (T_CS), IC13.66 (PC9/TIM8_CH4/SDIO_D1)
GPIOC10: DSP1.18 (T_CLK), IC13.78 (PC10/SDIO_D2)
GPIOC11: DSP1.26 (T_DO), IC13.79 (PC11/SDIO_D3)
GPIOC12: DSP1.22 (T_DIN), IC13.80 (PC12/SDIO_CK)
GPIOC13: IC13.7 (PC13); also elsewhere on the board
GPIOC14: IC13.8 (PC14/OSC32_IN); also elsewhere on the board
GPIOC15: IC13.9 (PC15/OSC32_OUT); also elsewhere on the board
GPIOD2: IC13.83 (PD2/SDIO_CMD); also elsewhere on the board
GPIOD3: DSP1.36 (SD_CS), IC13.84 (PD3/FSMC_CLK)
GPIOD6: IC13.87 (PD6/USART2_RX)
GPIOD13: IC13.60 (PD13/FSMC_A18/TIM4_CH2); also elsewhere on the board
GPIOE0: IC13.97 (PE0); also elsewhere on the board
GPIOE1: IC13.98 (PE1); also elsewhere on the board
GPIOE2: IC13.1 (PE2/FSMC_A23); also elsewhere on the board
GPIOE3: IC13.2 (PE3/FSMC_A19); also elsewhere on the board
GPIOE4: IC13.3 (PE4/FSMC_A20); also elsewhere on the board
GPIOE5: IC13.4 (PE5/FSMC_A21/TIM9_CH2)
GPIOE6: IC13.5 (PE6/FSMC_A22/TIM9_CH2); also elsewhere on the board
IMESS: IC13.35 (PB0/TIM3_CH3); also elsewhere on the board
LDCLIGHT: DSP1.37 (LED_A); also elsewhere on the board
unnamed: LED1.3 (CRED), R102.1
unnamed: C64.1, IC12.3 (C1-)
unnamed: C64.2, IC12.1 (C1+)
unnamed: C65.2, IC12.4 (C2+)
unnamed: C65.1, IC12.5 (C2-)
unnamed: C58.1, IC12.2 (V+)
unnamed: C57.2, IC12.6 (V-)
unnamed: IC12.10 (T2IN), IC12.11 (T1IN), IC13.47 (PB10/USART3_TX)
unnamed: C59.2, IC12.14 (T1OUT), R92.2
unnamed: C53.2, Q13.3 (D), Q14.1 (G), R94.2, R96.1
unnamed: IC12.12 (R1OUT), IC13.48 (PB11/USART3_RX)
unnamed: Q14.3 (D), Q16.1 (G), R98.1
unnamed: IC13.69 (PA10/USB_ID/USART1_RX), Q16.3 (D), R99.1
unnamed: C56.2, IC12.8 (R2IN), IC12.13 (R1IN), R93.2
unnamed: IC13.68 (PA9/USB_VBUS/USART1_TX), Q15.1 (G)
unnamed: Q13.1 (G), Q15.3 (D), R97.1
unnamed: LED1.4 (CGREEN), R103.1
unnamed: C113.2, JP4.1, R92.1
unnamed: C112.2, JP4.3, R93.1
unnamed: C111.2, JP4.5, R94.1
unnamed: C83.2, C84.2, IC13.73 (VCAP2)
unnamed: IC13.12 (PH0/OSC_IN), OSC1.3 (OUT)
unnamed: C81.2, C82.2, IC13.49 (VCAP1)
unnamed: C73.1, C74.2, IC13.22 (VDDA), R101.2
unnamed: C55.2, IC13.14 (RST), R95.2, ST3.5
unnamed: IC13.94 (BOOT0), R100.2, ST4.2
unnamed: IC13.76 (PA14/JTCK), ST3.2
unnamed: IC13.72 (PA13/JTMS), ST3.4
unnamed: IC13.89 (PB3/JTDO), ST3.6
RS: DSP1.7 (RS), IC13.58 (PD11/FSMC_A16)
SWRESET: IC13.70 (PA11/USB_DM/TIM1_CH4)
SWSTANDBY: IC13.71 (PA12/USB_DP/CAN1_TX)
UBAND: IC13.23 (PA0/WKUP); also elsewhere on the board
UFWDANT: IC13.30 (PA5/DAC2); also elsewhere on the board
UFWDFLT: IC13.15 (PC0/OTG_HS_ULPI_STP); also elsewhere on the board
UFWDIN: IC13.36 (PB1/TIM3_CH4); also elsewhere on the board
UMESS: IC13.29 (PA4/DAC1); also elsewhere on the board
UREVANT: IC13.31 (PA6/TIM13_CH1/TIM3_CH1); also elsewhere on the board
UREVFLT: IC13.16 (PC1/ETH_MDC); also elsewhere on the board
UREVIN: IC13.17 (PC2/OTG_HS_ULPI_STP); also elsewhere on the board
UTEMP: IC13.32 (PA7/TIM14_CH1/TIM3_CH2); also elsewhere on the board
UTEMP2: IC13.18 (PC3/OTG_HS_ULPI_NXT); also elsewhere on the board
VCC: C54.1, C61.2, C66.2, C67.2, C68.2, C69.2, C70.2, C71.2, C72.2, C75.1, C76.1, C77.1, C78.1, C79.1, C80.1, DSP1.3 (3V3), IC12.16 (VCC), IC13.6 (VBAT), IC13.11 (VDD5), IC13.19 (VDD12), IC13.28 (VDD4), IC13.50 (VDD1), IC13.75 (VDD2), IC13.100 (VDD3), LED1.1 (A2), OSC1.1 (E/D), OSC1.4 (VCC), R95.1, R97.2, R98.2, R99.2, R101.1, ST3.1, ST4.1; also elsewhere on the board
VCCIO: C60.1, IC11.1 (K2); also elsewhere on the board
VREF2: C62.1, C63.2, IC11.2 (K1), IC13.21 (VREF+); also elsewhere on the board
WIFI_RXD: IC13.25 (PA2/USART2_TX); also elsewhere on the board
WIFI_TXD: IC13.26 (PA3/USART2_RX); also elsewhere on the board

Notes on the sheet:
BOOTLOAD
Power AMP Controller 7" Version 2 DJ0ABR u-Controller
TxD
RxD
Icom CI-V
Program Flash
Voltage Reference
STM32F427VGT6
JTDO
RST
JTMS
GND
Vcc
JTCK

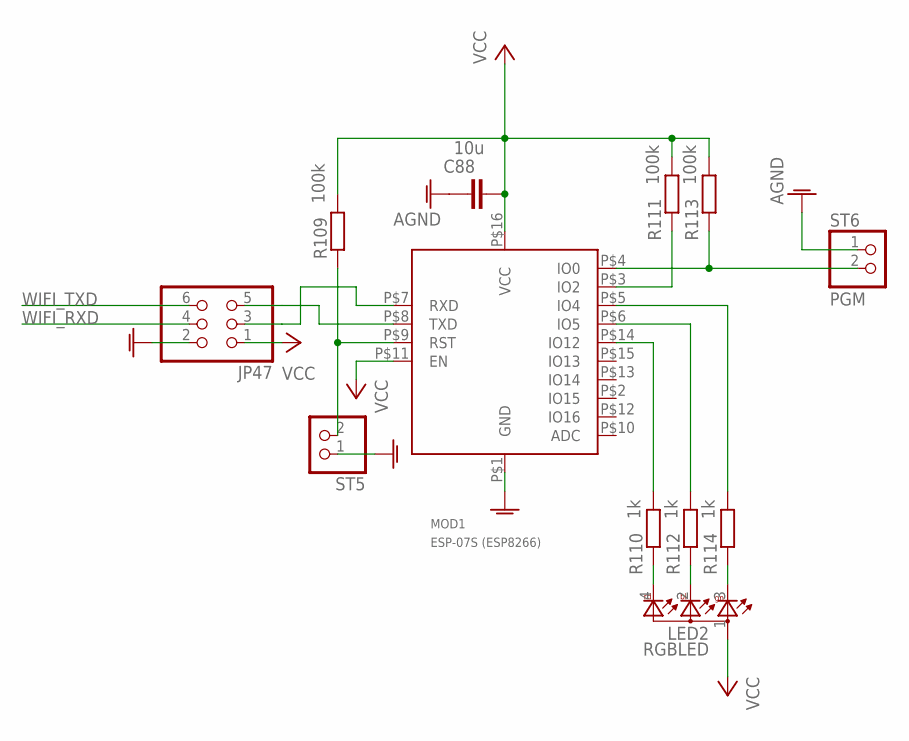
[picture p43: schematic display72.sch, sheet 5, WLAN IF]

Parts:
C88: 10u; C0805K
JP47: PINHD-2X3; 2X03
LED2: RGBLED; PLCC4_WE_LED
MOD1: ESP-07S (ESP8266); ESP8266-12
R109, R111, R113: 100k; R0603
R110, R112, R114: 1k; R0603
ST5: PINHEAD2X1BIG; PINHEAD1X2BIG
ST6: PGM; PINHEAD1X2

Connections:
AGND: C88.1, JP47.2, MOD1.P$1 (GND), ST5.1, ST6.1; also elsewhere on the board
unnamed: MOD1.P$4 (IO0), R113.1, ST6.2
unnamed: LED2.3 (CRED), R114.1
unnamed: LED2.2 (CBLUE), R112.1
unnamed: LED2.4 (CGREEN), R110.1
unnamed: MOD1.P$14 (IO12), R110.2
unnamed: MOD1.P$6 (IO5), R112.2
unnamed: MOD1.P$9 (RST), R109.1, ST5.2
unnamed: MOD1.P$3 (IO2), R111.1
unnamed: MOD1.P$5 (IO4), R114.2
unnamed: JP47.3, MOD1.P$7 (RXD)
unnamed: JP47.5, MOD1.P$8 (TXD)
VCC: C88.2, JP47.1, LED2.1 (A2), MOD1.P$11 (EN), MOD1.P$16 (VCC), R109.2, R111.2, R113.2; also elsewhere on the board
WIFI_RXD: JP47.4; also elsewhere on the board
WIFI_TXD: JP47.6; also elsewhere on the board
