righttoroam/stantonbury/05_Schematics_PCB/Eagle/display72.brd

## EAGLE design 05_Schematics_PCB/Eagle/display72.brd (continued)

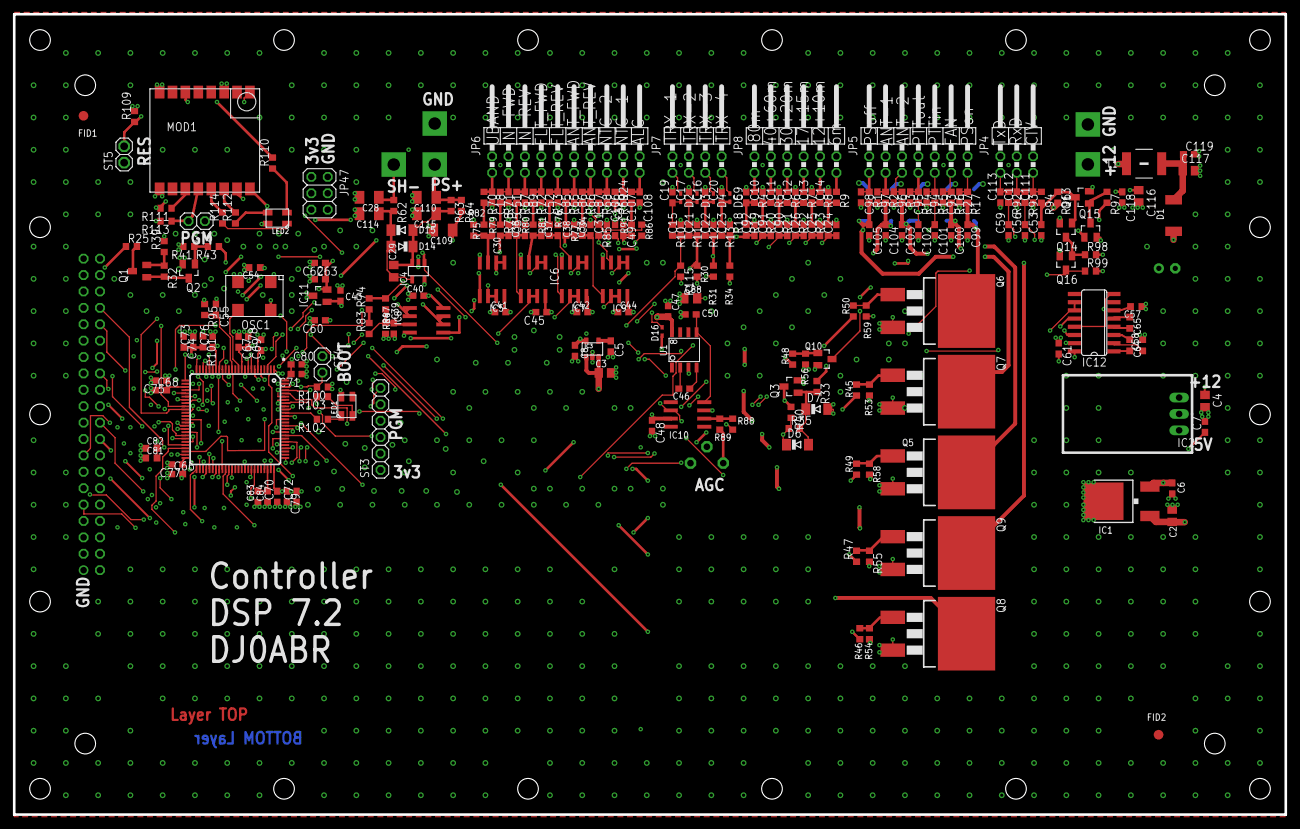
[picture p44: board display72.brd from above]

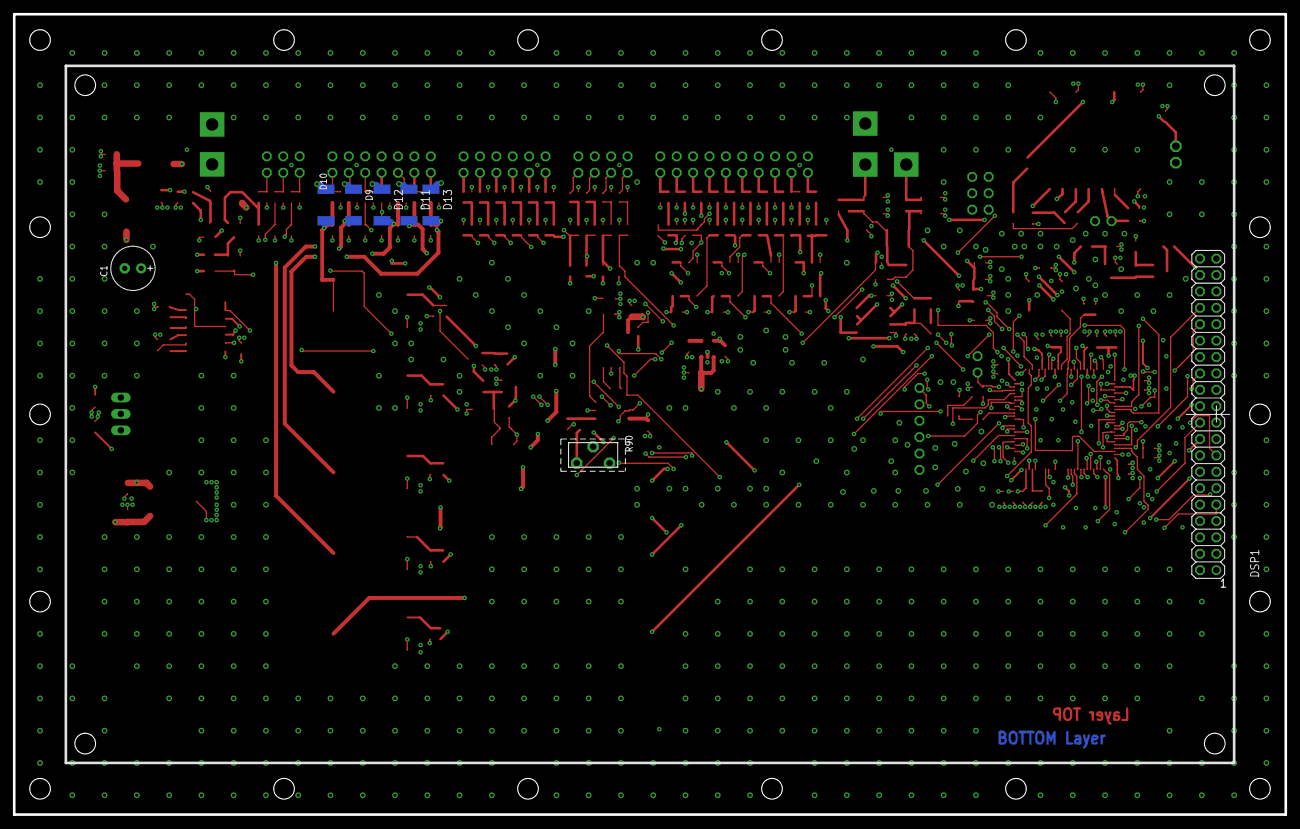
[picture p45: board display72.brd from below]

Board: 4 copper layers, 197.0 x 124.0 mm, 280 parts (10 on the bottom side), 198 nets.
