righttoroam/stantonbury/04_Firmware/ws2307wifi/serial.ino

// data received from the dsp7 are stored here
unsigned char ws_rxdata[RXSTRLEN];


extern unsigned char txcfg[300];
extern int txcfg_len;


// read data from dsp7
void ws_getdata()
{
int d,i;
unsigned char rxsum, sum, len;

  
  if(!Serial.available()) return;
  
  d = Serial.read();
  if(d == -1) return;


  // Daten wurden empfangen
  // schreibe das empfangene Byte in ws_rxdata
  // schiebe alles bisher empfangene nach vorn
  for(i=0; i<(RXSTRLEN-1); i++)
    ws_rxdata[i] = ws_rxdata[i+1];

  ws_rxdata[RXSTRLEN-1] = d;

  // der Datensatz ist komplett wenn vorne der Header drin steht
  if(ws_rxdata[0] == 0x1e &&
    ws_rxdata[1] == 0x7c &&
    ws_rxdata[2] == 0xfe &&
    ws_rxdata[3] == 0x56)
    {
      evaluate_DSP7data0(ws_rxdata);
    }
    
    if(ws_rxdata[0] == 0x64 &&
    ws_rxdata[1] == 0x78 &&
    ws_rxdata[2] == 0xab &&
    ws_rxdata[3] == 0x61)
    {
      evaluate_DSP7data1(ws_rxdata);
    }

    if(ws_rxdata[0] == 0x01 &&
    ws_rxdata[1] == 0x02 &&
    ws_rxdata[2] == 0x03 &&
    ws_rxdata[3] == 0x05)
    {
      evaluate_DSP7data2(ws_rxdata);
    }
}

char switchDSP7_off;
char switchDSP7_on;
char switchDSP7_standby;
char switchDSP7_active;

void dsp_sendcontrol()
{
unsigned char tx[5];
static int first = 1;

  tx[0] = 0;

  if(txcfg_len != 0)
  {
    Serial.write(txcfg,txcfg_len);
    txcfg_len = 0;
    return;
  }

  if(first)
  {
    // Nach dem Programmstart melde dich bei DSP-7
    first = 0;

    tx[0] = 1;
    tx[1] = 2;
    tx[2] = 3;
    tx[3] = 7;
    Serial.write(tx,4);
    return;
  }
  
  if(switchDSP7_off == 1)
  {
    switchDSP7_off = 0;
    tx[0] = 1;
    tx[1] = 2;
    tx[2] = 3;
    tx[3] = 1;
  }
  if(switchDSP7_on == 1)
  {
    switchDSP7_on = 0;
    tx[0] = 1;
    tx[1] = 2;
    tx[2] = 3;
    tx[3] = 2;
  }
  if(switchDSP7_standby == 1)
  {
    switchDSP7_standby = 0;
    tx[0] = 1;
    tx[1] = 2;
    tx[2] = 3;
    tx[3] = 3;
  }
  if(switchDSP7_active == 1)
  {
    switchDSP7_active = 0;
    tx[0] = 1;
    tx[1] = 2;
    tx[2] = 3;
    tx[3] = 4;
  }
  if(tx[0] != 0) 
    Serial.write(tx,4);
}

void ws_sendIP()
{
unsigned char tx[4];

  strcpy(wxval[IPADDRESS].sval,const_cast<char*>(WiFi.localIP().toString().c_str()));

  tx[0] = 1;
  tx[1] = 2;
  tx[2] = 3;
  tx[3] = 6;
  Serial.write(tx,4);
  Serial.write(wxval[IPADDRESS].sval,20);
}

void dsp7_send()
{
static long lastsend = 0;

  // sende Web Kommandos
  dsp_sendcontrol();

  // sende eigene lokale IP alle 2s
  if((millis()-lastsend)>(2*1000))
  {
    lastsend = millis();
    ws_sendIP();
  }
}
