righttoroam/stantonbury/(commit log)

2020-11-07 added file structure and heatsink spreadsheet
    [Heatsink calc.ods]
2020-11-07 added firmware from DJ0ABR at v1.8
    [display7 Run.cfg]
2020-11-08 tidy up, add scehmatics
    [display72.GBP, display72.GTO, display72.GTP]
2020-11-09 Updated pin assignments
    [PA600 Micro Pin Assignments V3.ods]
2020-11-09 Added datasheets, calcs and target spec
    [Feasibility spreadsheets.ods, Heatsink calc.ods]
2020-11-09 Replaced feasibility spreadsheet with mass est
    [Feasibility spreadsheets.ods, Mass estimate.ods]
2020-11-10 More reference materials
2020-11-11 Controller PCB added
    [ANALOG.sch, CPU.sch, IO_Ports_LED,PTT,Switch.sch, Powersupply.sch, WLAN_IF.sch, display72.brd, display72.kicad_pcb, display72.sch]
